RobinEpo/Star-Trekker-Microver/PCBs/for_review/StarTrekker_main_3D.png

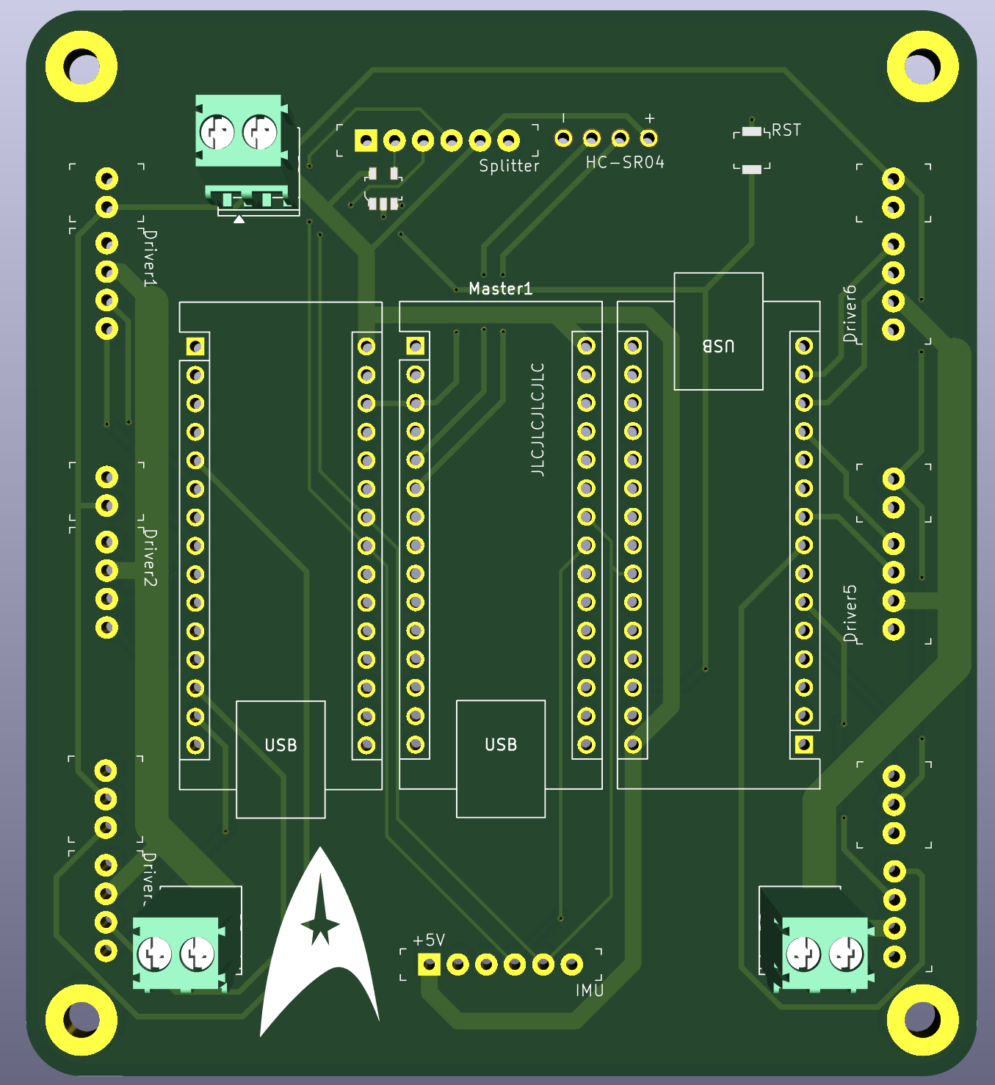
PCBs/for_review/StarTrekker_main_3D.png
