RobinEpo/Star-Trekker-Microver/PCBs/for_review/StarTrekker_main_BOTTOM_LAYER.png

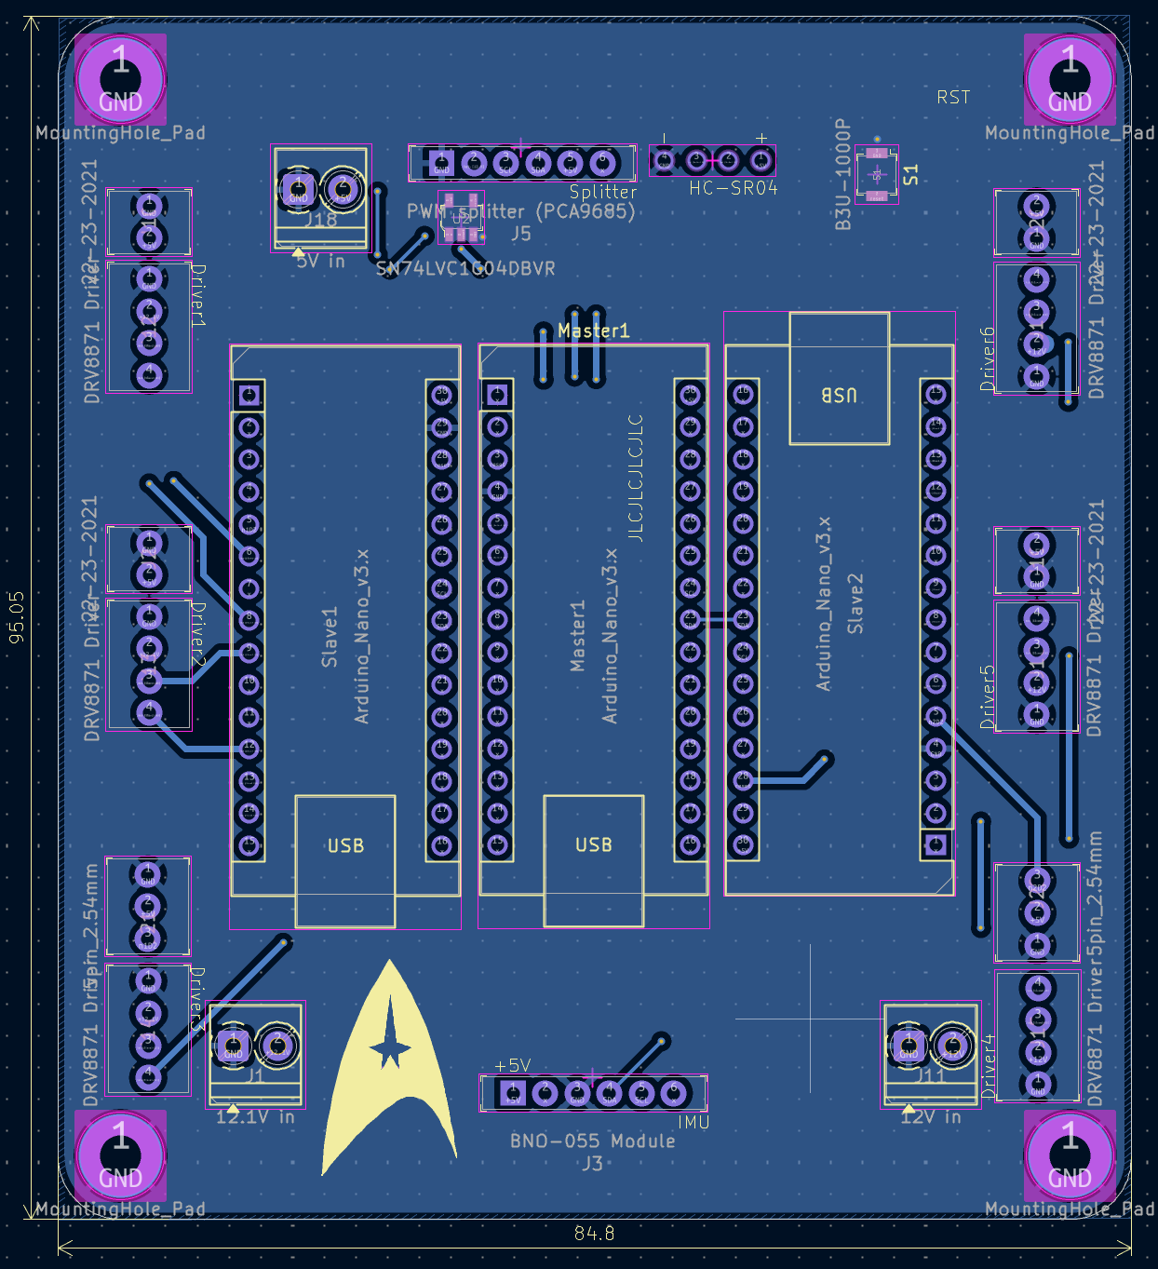
PCBs/for_review/StarTrekker_main_BOTTOM_LAYER.png
