RobinEpo/Star-Trekker-Microver/PCBs/for_review/StarTrekker_main_FULL_LAYOUT.png

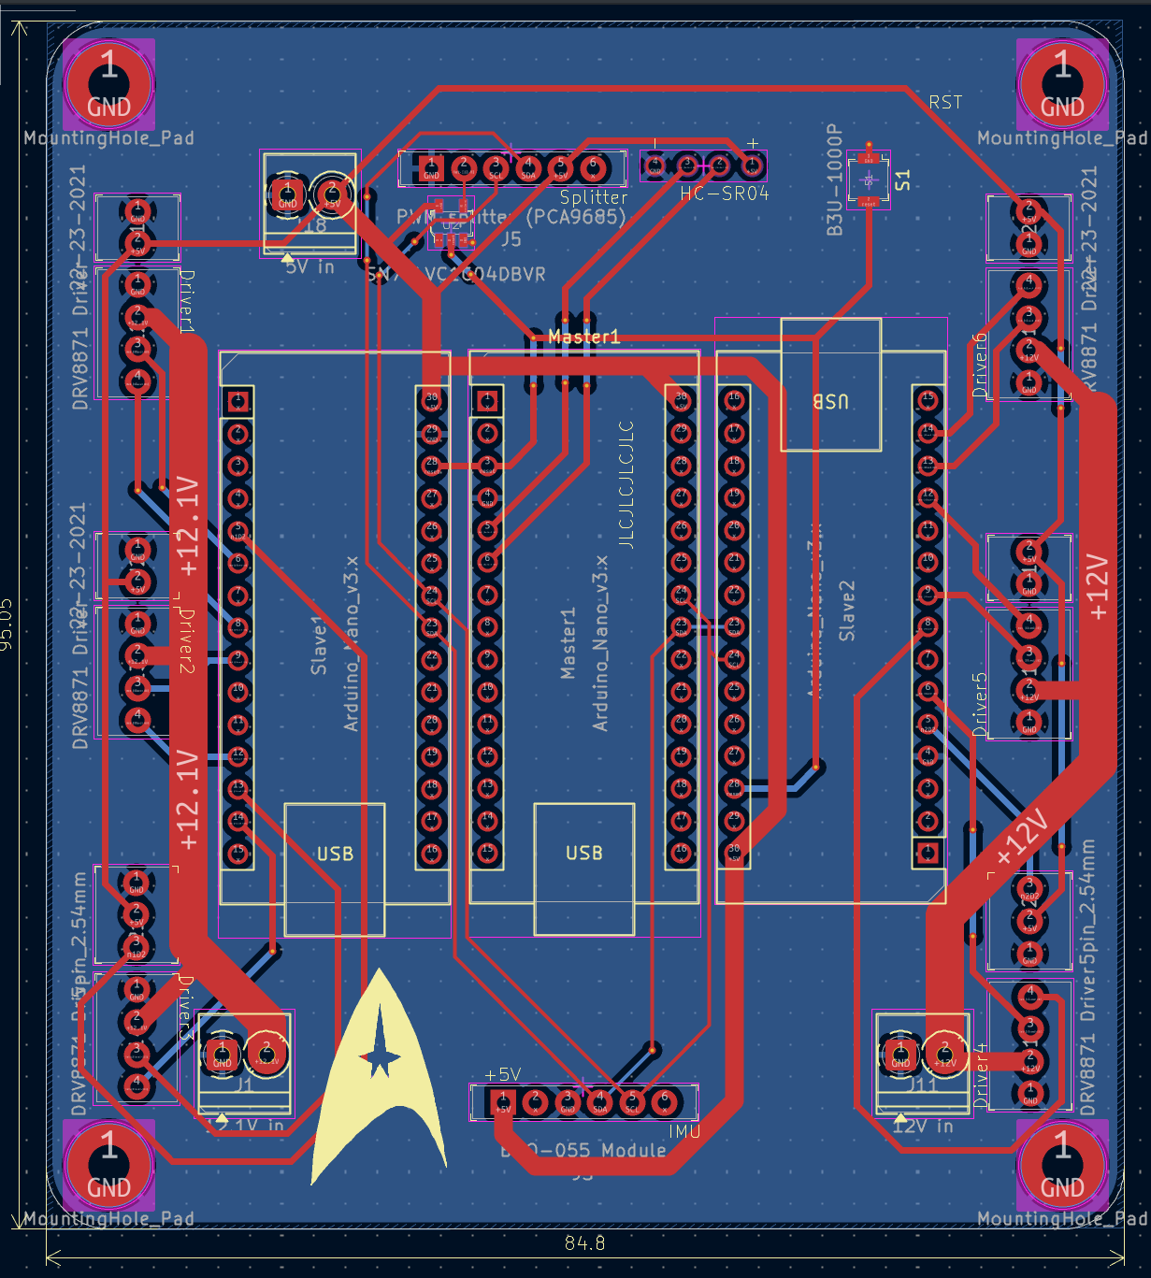
PCBs/for_review/StarTrekker_main_FULL_LAYOUT.png
