RobinEpo/Star-Trekker-Microver/PCBs/for_review/StarTrekker_main_SCHEMATIC.png

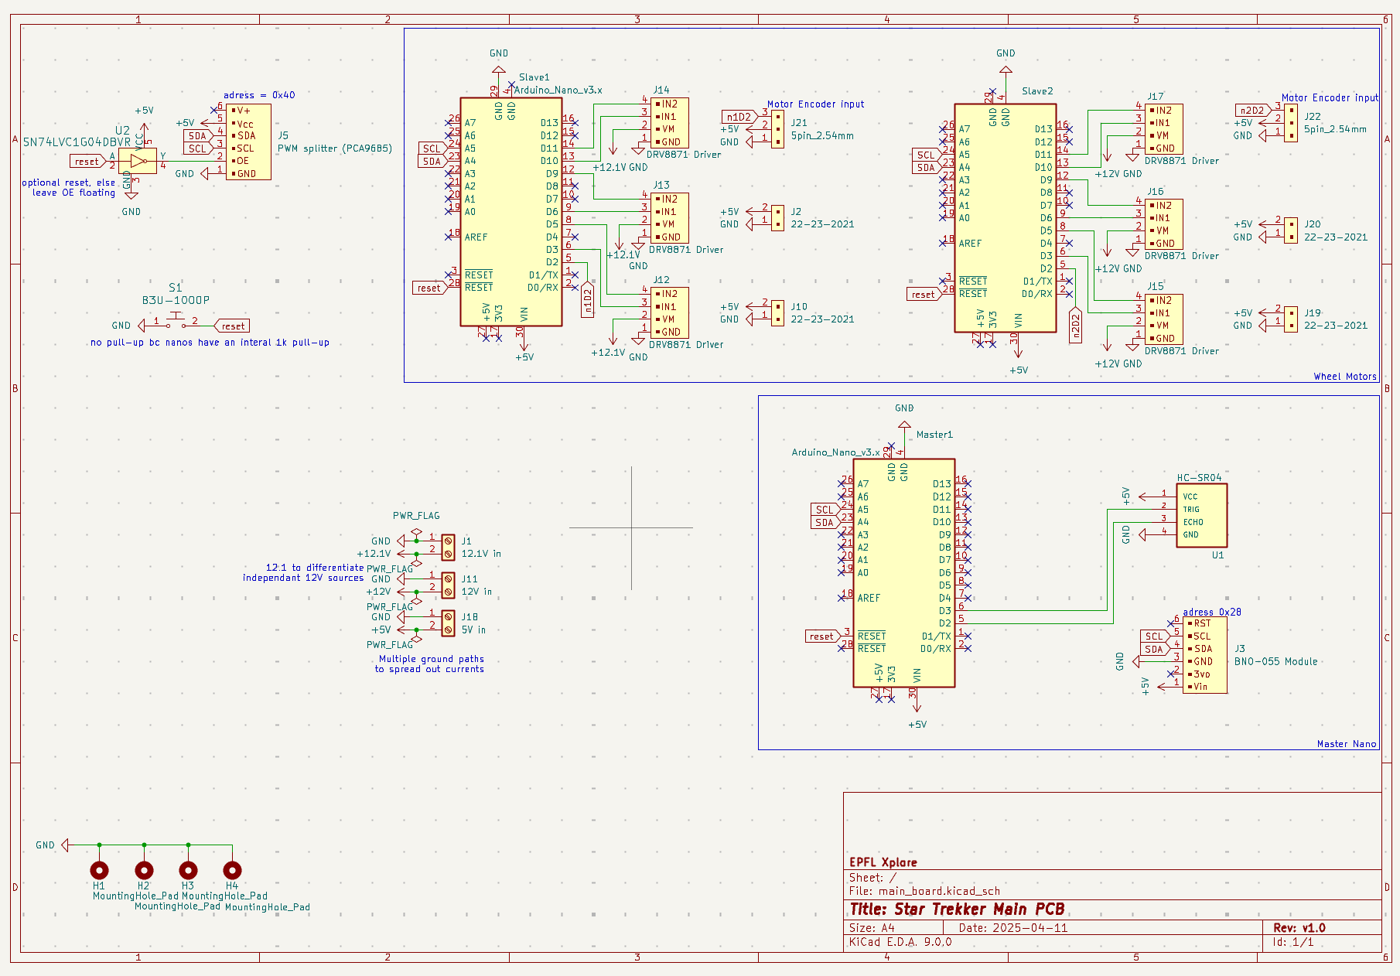
PCBs/for_review/StarTrekker_main_SCHEMATIC.png
