RobinEpo/Star-Trekker-Microver/PCBs/for_review/StarTrekker_pwrboard_3D.png

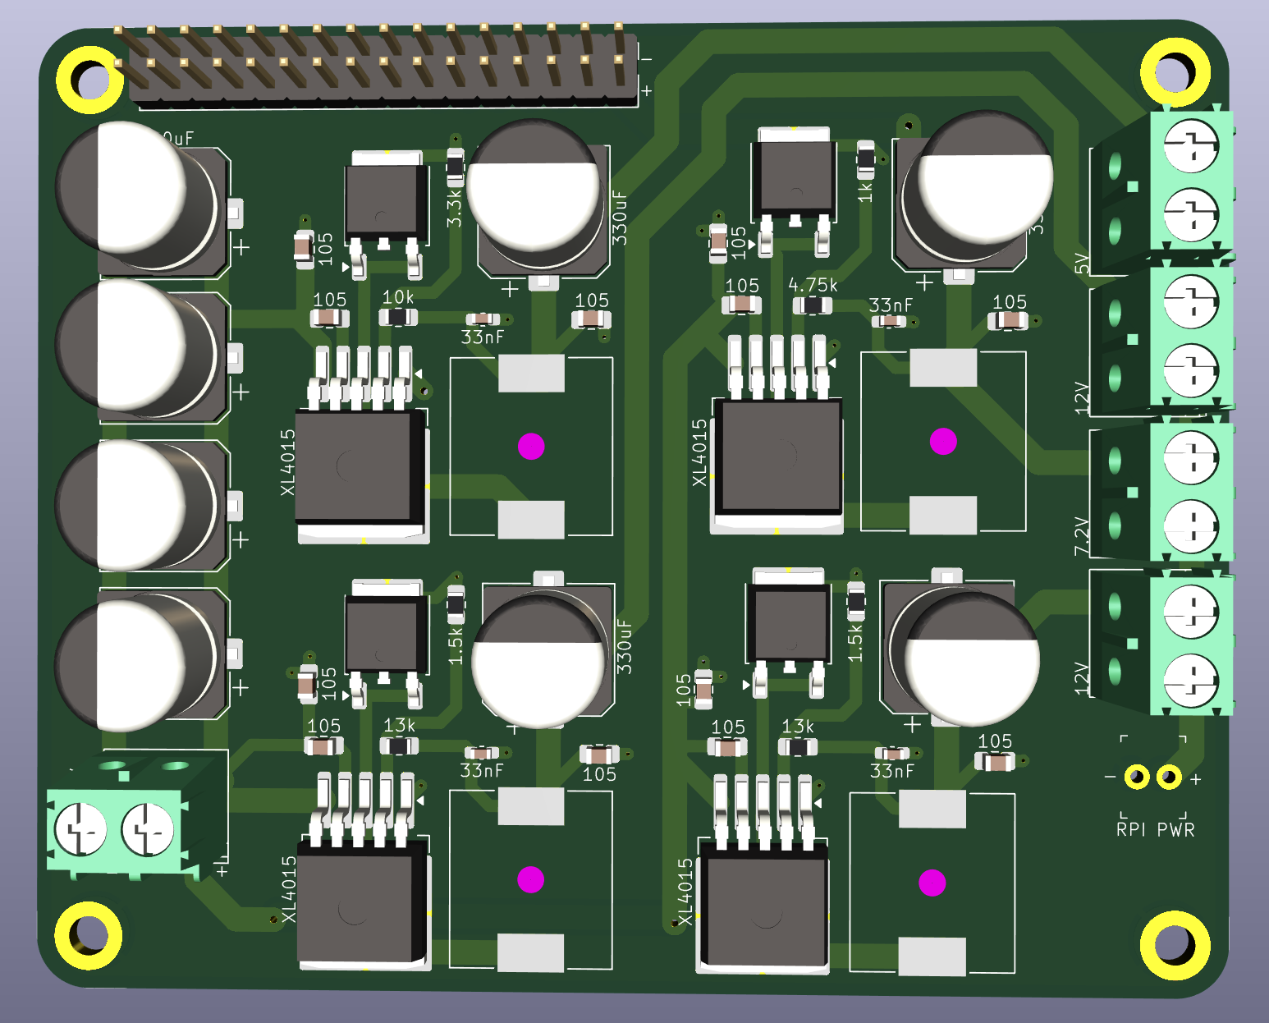
PCBs/for_review/StarTrekker_pwrboard_3D.png
