RobinEpo/Star-Trekker-Microver/PCBs/for_review/StarTrekker_pwrboard_BUTTOM_LAYER.png

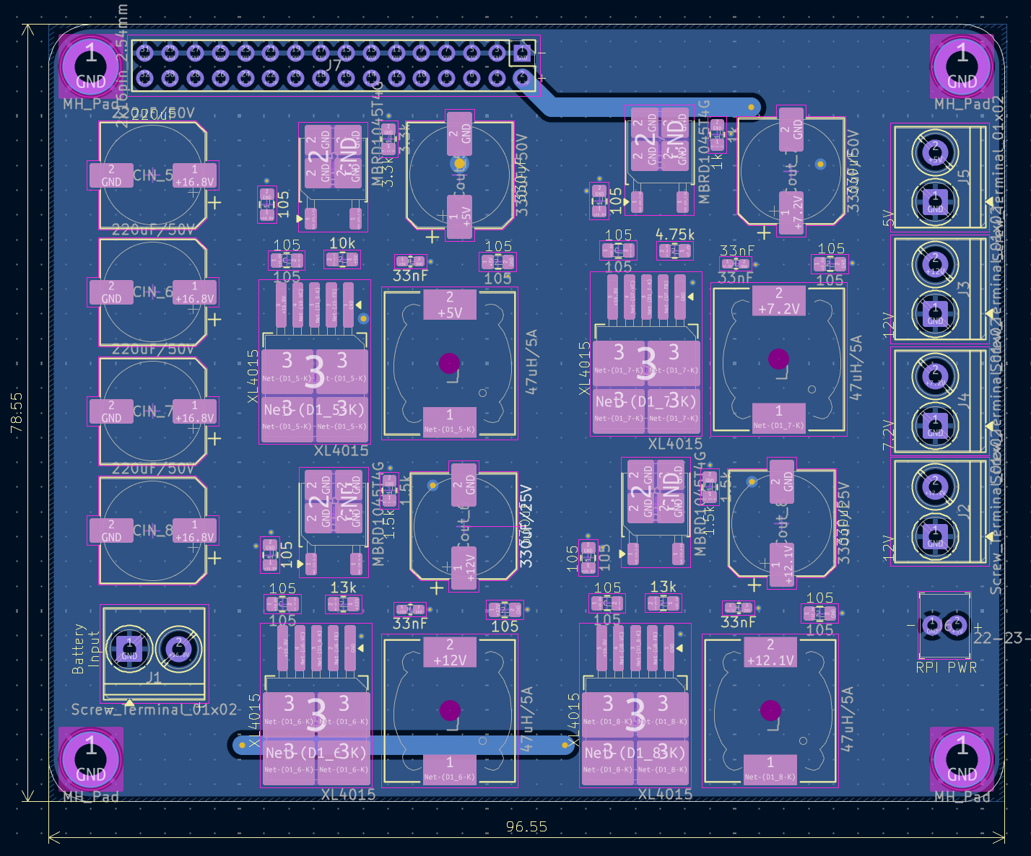
PCBs/for_review/StarTrekker_pwrboard_BUTTOM_LAYER.png
