RobinEpo/Star-Trekker-Microver/PCBs/for_review/StarTrekker_pwrboard_FULL_LAYOUT.png

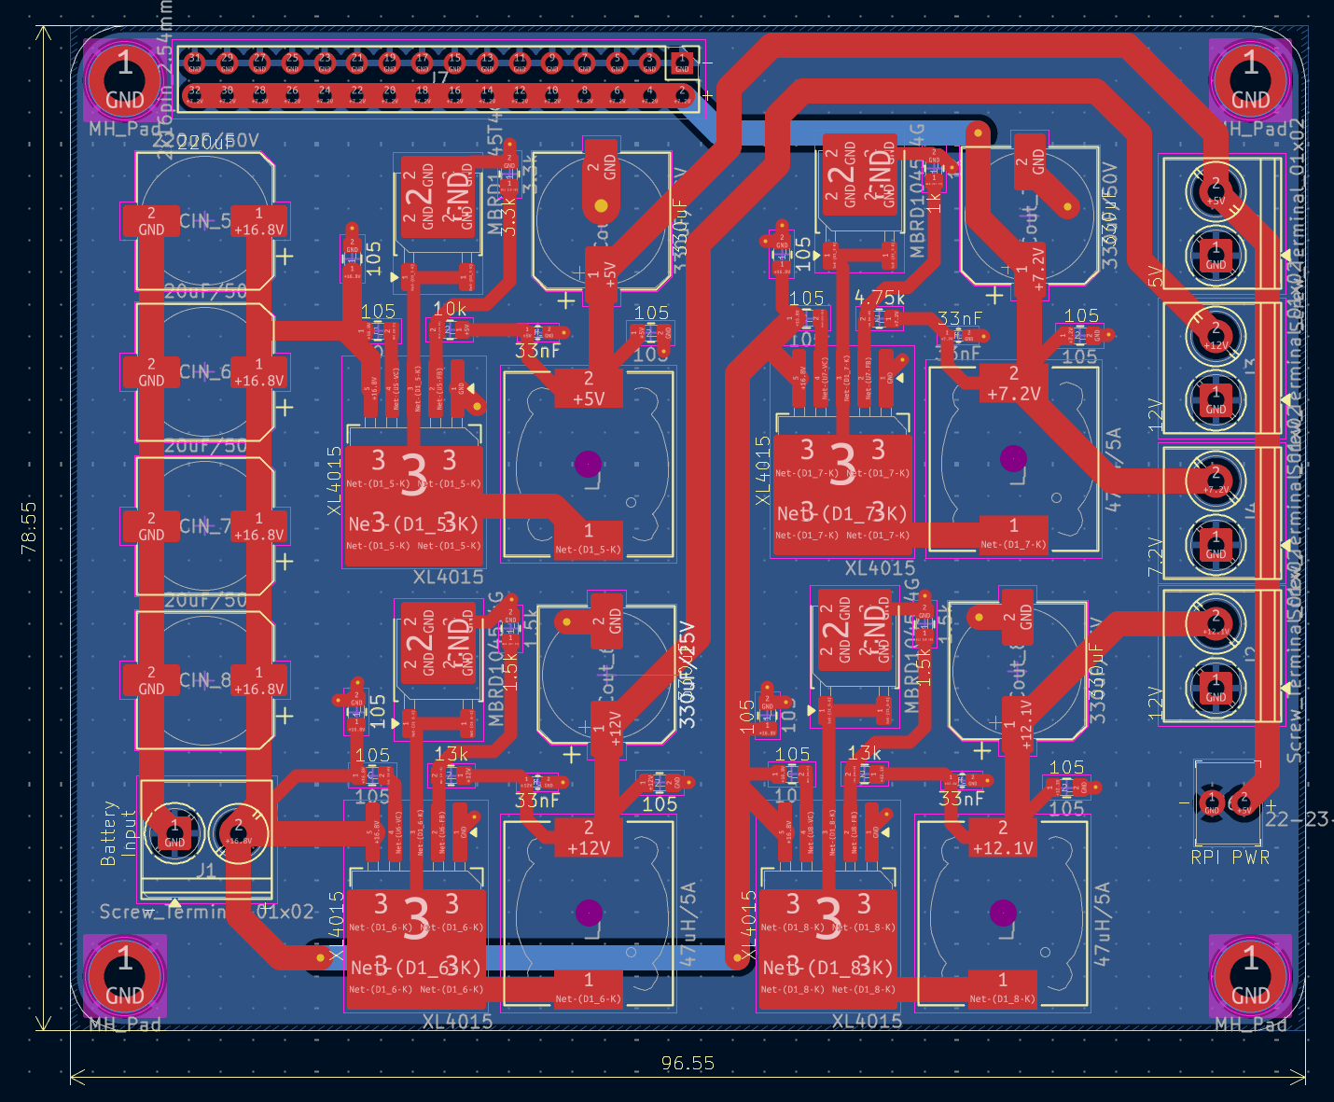
PCBs/for_review/StarTrekker_pwrboard_FULL_LAYOUT.png
