RobinEpo/Star-Trekker-Microver/PCBs/for_review/StarTrekker_pwrboard_SCHEMATIC.png

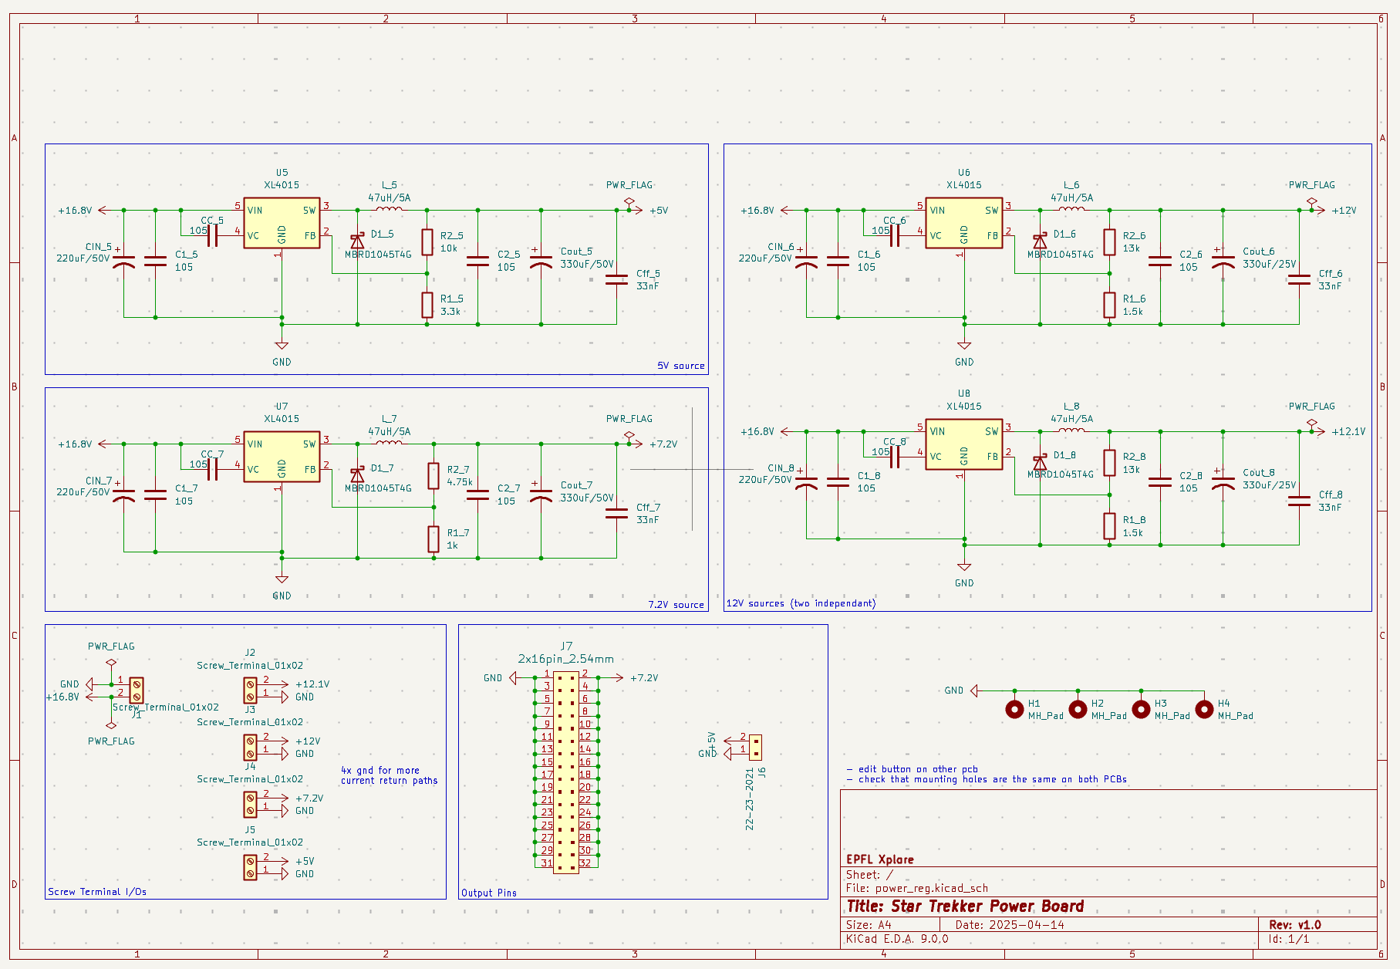
PCBs/for_review/StarTrekker_pwrboard_SCHEMATIC.png
