RobinEpo/Star-Trekker-Microver/PCBs/for_review/PwrReg_schematic.pdf

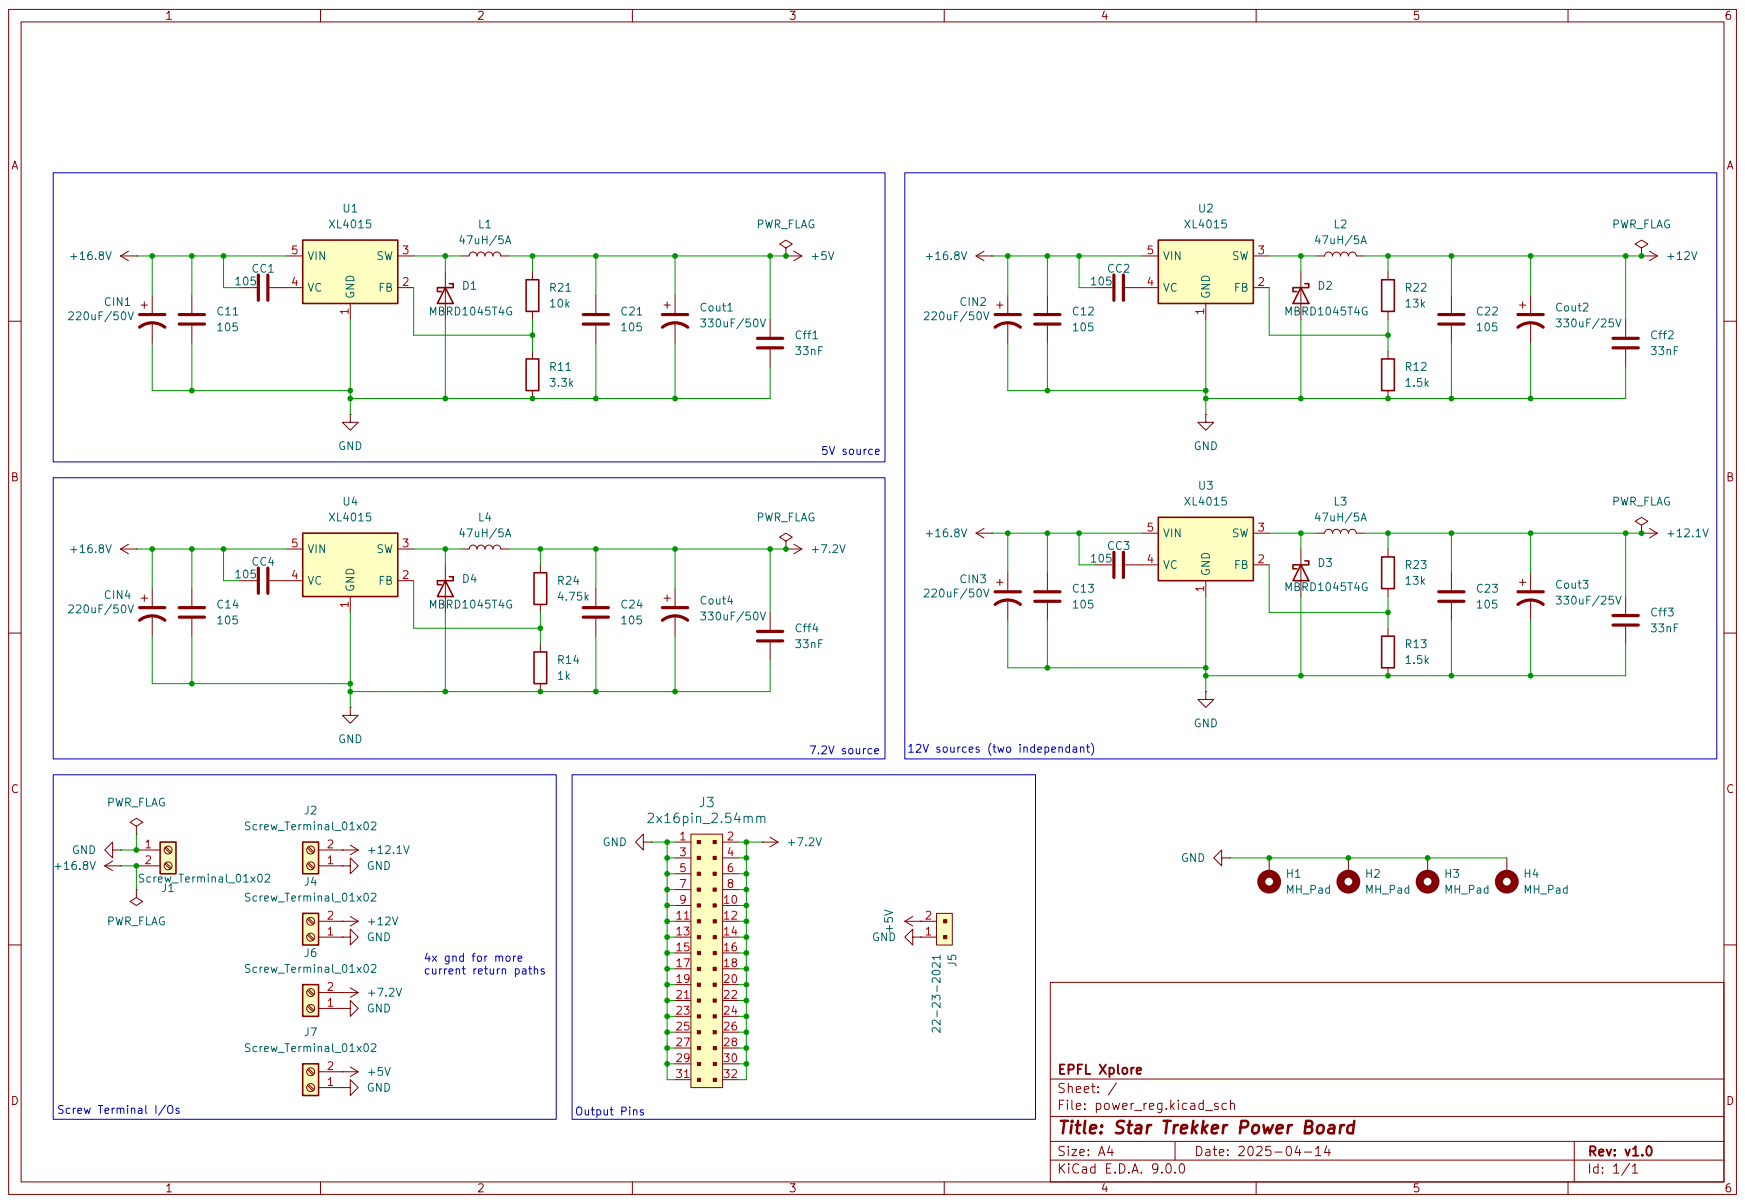
[picture p9: page 1]
