RobinEpo/Star-Trekker-Microver/PCBs/power_reg/power_reg.kicad_pcb

## KiCad design PCBs/power_reg/power_reg.kicad_pcb (2025-05-09)

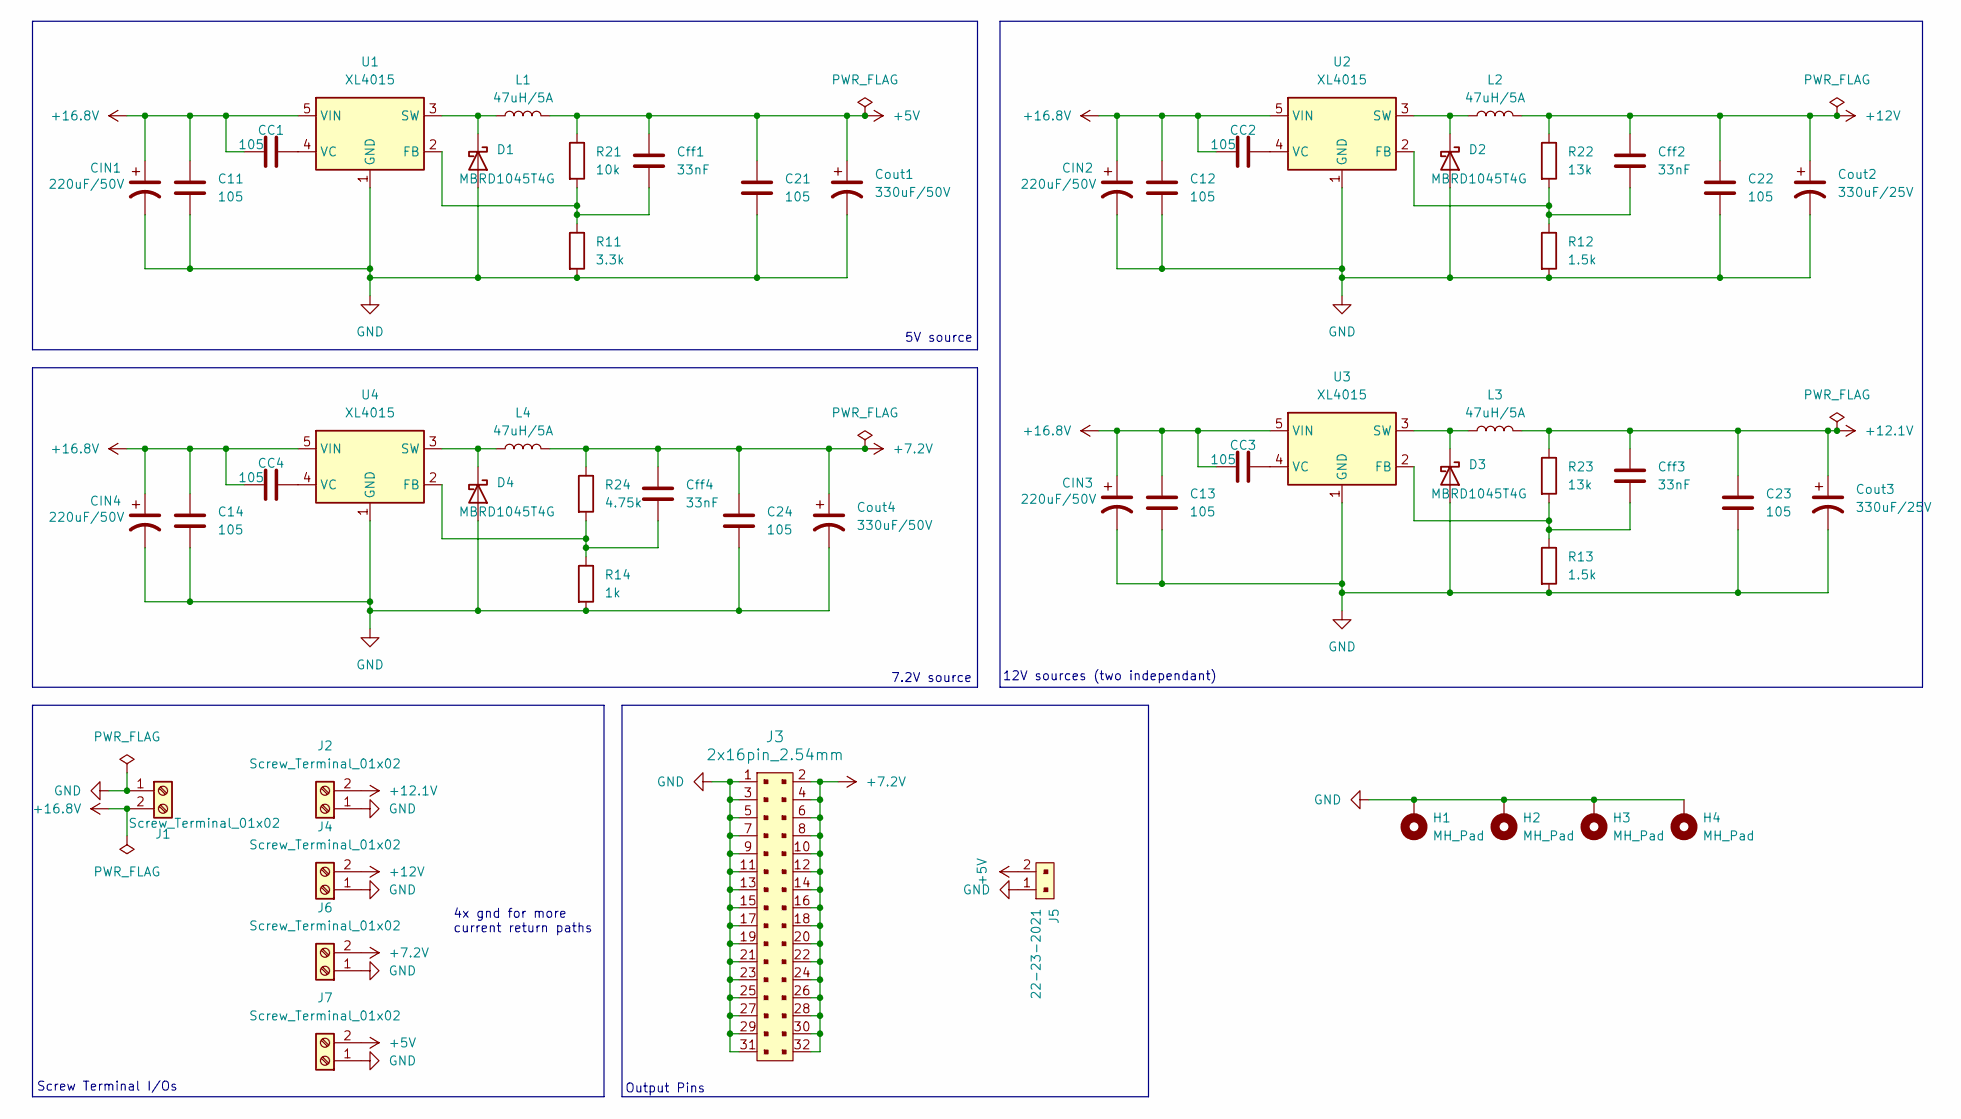
[picture p10: schematic power_reg.kicad_sch, Star Trekker Power Board]

Parts:
C11, C12, C13, C14, C21, C22, C23, C24: 105; C_0805_2012Metric_Pad1.18x1.45mm_HandSolder
CC1, CC2, CC3, CC4: 105; C_0805_2012Metric_Pad1.18x1.45mm_HandSolder
CIN1, CIN2, CIN3, CIN4: 220uF/50V; CP_Elec_10x10.5
Cff1, Cff2, Cff3, Cff4: 33nF; C_0603_1608Metric_Pad1.08x0.95mm_HandSolder
Cout1, Cout4: 330uF/50V; CP_Elec_10x10.5
Cout2, Cout3: 330uF/25V; CP_Elec_10x10.5
D1, D2, D3, D4: MBRD1045T4G; TO-252-2
H1, H2, H3, H4: MH_Pad; MountingHole_3.2mm_M3_DIN965_Pad
J1, J2, J4, J6, J7: Screw_Terminal_01x02; TerminalBlock_Phoenix_PT-1,5-2-5.0-H_1x02_P5.00mm_Horizontal
J3: 2x16pin_2.54mm; PinHeader_2x16_P2.54mm_Vertical; MPN 3220-10-0100-00; Digi-Key_PN 1175-1627-ND
J5: 22-23-2021; PinHeader_1x2_P2.54mm_Drill1.02mm; MPN 22-23-2021; Digi-Key_PN WM4200-ND
L1, L2, L3, L4: 47uH/5A; L_13.8x12.6mm_H6.5mm
R11: 3.3k; R_0805_2012Metric_Pad1.20x1.40mm_HandSolder
R12, R13: 1.5k; R_0805_2012Metric_Pad1.20x1.40mm_HandSolder
R14: 1k; R_0805_2012Metric_Pad1.20x1.40mm_HandSolder
R21: 10k; R_0805_2012Metric_Pad1.20x1.40mm_HandSolder
R22, R23: 13k; R_0805_2012Metric_Pad1.20x1.40mm_HandSolder
R24: 4.75k; R_0805_2012Metric_Pad1.20x1.40mm_HandSolder
U1, U2, U3, U4: XL4015; TO-263-5_TabPin3

Connections:
+5V: C21.1, Cff1.1, Cout1.1, J5.2, J7.2, L1.2, R21.1
+7.2V: C24.1, Cff4.1, Cout4.1, J3.2, J3.4, J3.6, J3.8, J3.10, J3.12, J3.14, J3.16, J3.18, J3.20, J3.22, J3.24, J3.26, J3.28, J3.30, J3.32, J6.2, L4.2, R24.1
+12.1V: C23.1, Cff3.1, Cout3.1, J2.2, L3.2, R23.1
+12V: C22.1, Cff2.1, Cout2.1, J4.2, L2.2, R22.1
+16.8V: C11.1, C12.1, C13.1, C14.1, CC1.1, CC2.1, CC3.1, CC4.1, CIN1.1, CIN2.1, CIN3.1, CIN4.1, J1.2, U1.5 (VIN), U2.5 (VIN), U3.5 (VIN), U4.5 (VIN)
GND: C11.2, C12.2, C13.2, C14.2, C21.2, C22.2, C23.2, C24.2, CIN1.2, CIN2.2, CIN3.2, CIN4.2, Cout1.2, Cout2.2, Cout3.2, Cout4.2, D1.1 (A), D2.1 (A), D3.1 (A), D4.1 (A), H1.1, H2.1, H3.1, H4.1, J1.1, J2.1, J3.1, J3.3, J3.5, J3.7, J3.9, J3.11, J3.13, J3.15, J3.17, J3.19, J3.21, J3.23, J3.25, J3.27, J3.29, J3.31, J4.1, J5.1, J6.1, J7.1, R11.2, R12.2, R13.2, R14.2, U1.1 (GND), U2.1 (GND), U3.1 (GND), U4.1 (GND)
unnamed: D1.2 (K), L1.1, U1.3 (SW)
unnamed: D2.2 (K), L2.1, U2.3 (SW)
unnamed: D3.2 (K), L3.1, U3.3 (SW)
unnamed: D4.2 (K), L4.1, U4.3 (SW)
unnamed: Cff1.2, R11.1, R21.2, U1.2 (FB)
unnamed: CC1.2, U1.4 (VC)
unnamed: Cff2.2, R12.1, R22.2, U2.2 (FB)
unnamed: CC2.2, U2.4 (VC)
unnamed: Cff3.2, R13.1, R23.2, U3.2 (FB)
unnamed: CC3.2, U3.4 (VC)
unnamed: Cff4.2, R14.1, R24.2, U4.2 (FB)
unnamed: CC4.2, U4.4 (VC)

Notes on the sheet:
Output Pins
5V source
Screw Terminal I/Os
7.2V source
12V sources (two independant)
4x gnd for more current return paths

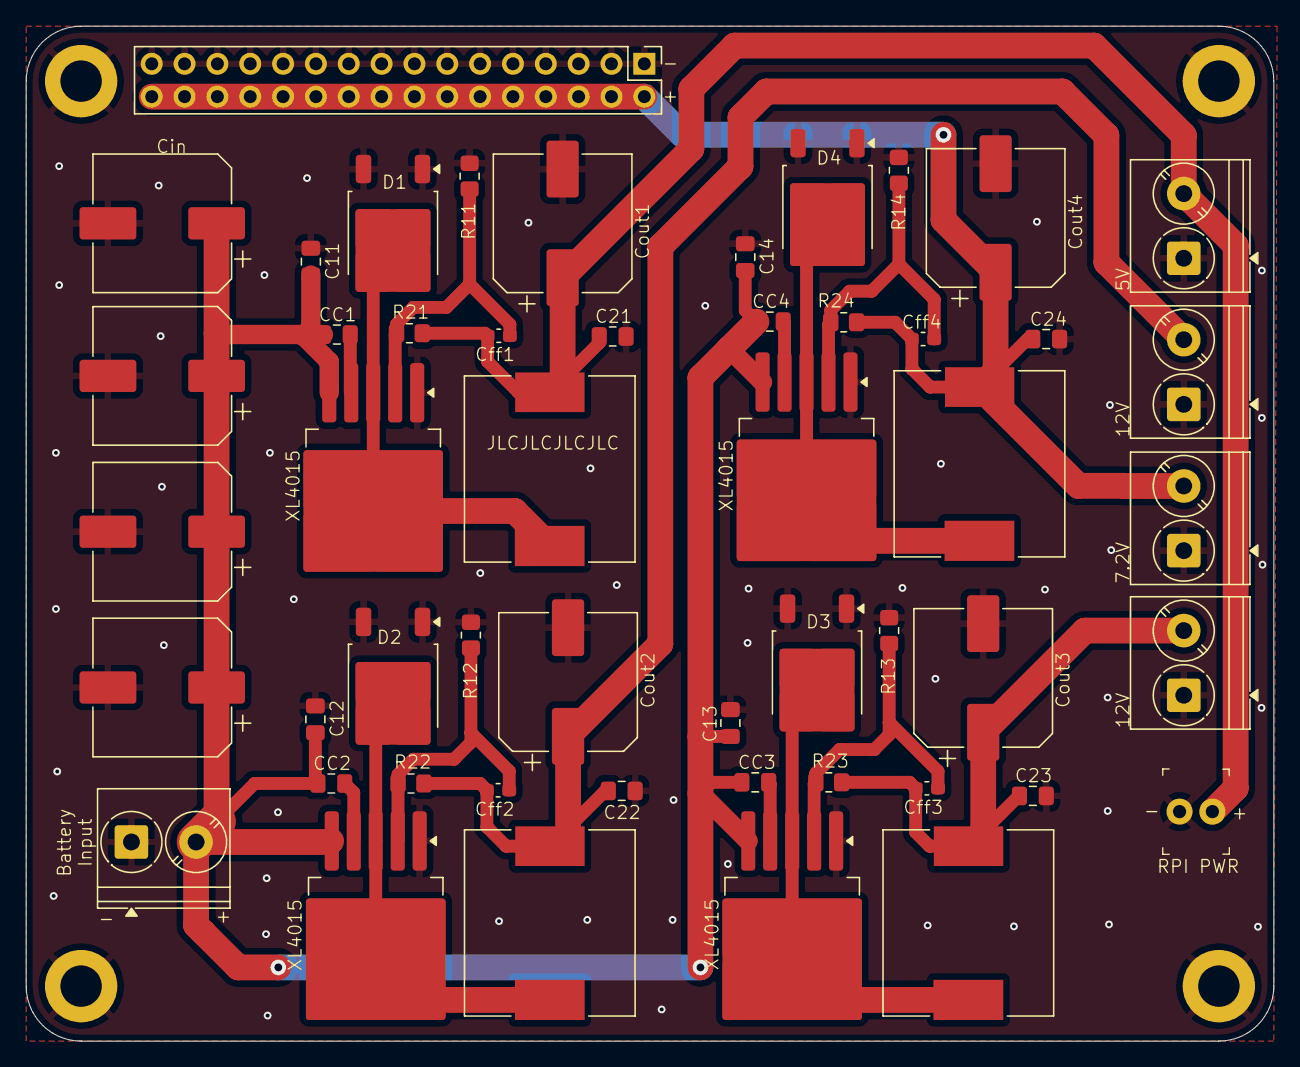
[picture p11: board power_reg.kicad_pcb from above]

Board: 2 copper layers, 96.5 x 78.5 mm, 55 parts (0 on the bottom side), 18 nets.
