RobinEpo/Star-Trekker-Microver/PCBs/main_board/main_board.kicad_pcb

## KiCad design PCBs/main_board/main_board.kicad_pcb (2025-05-09)

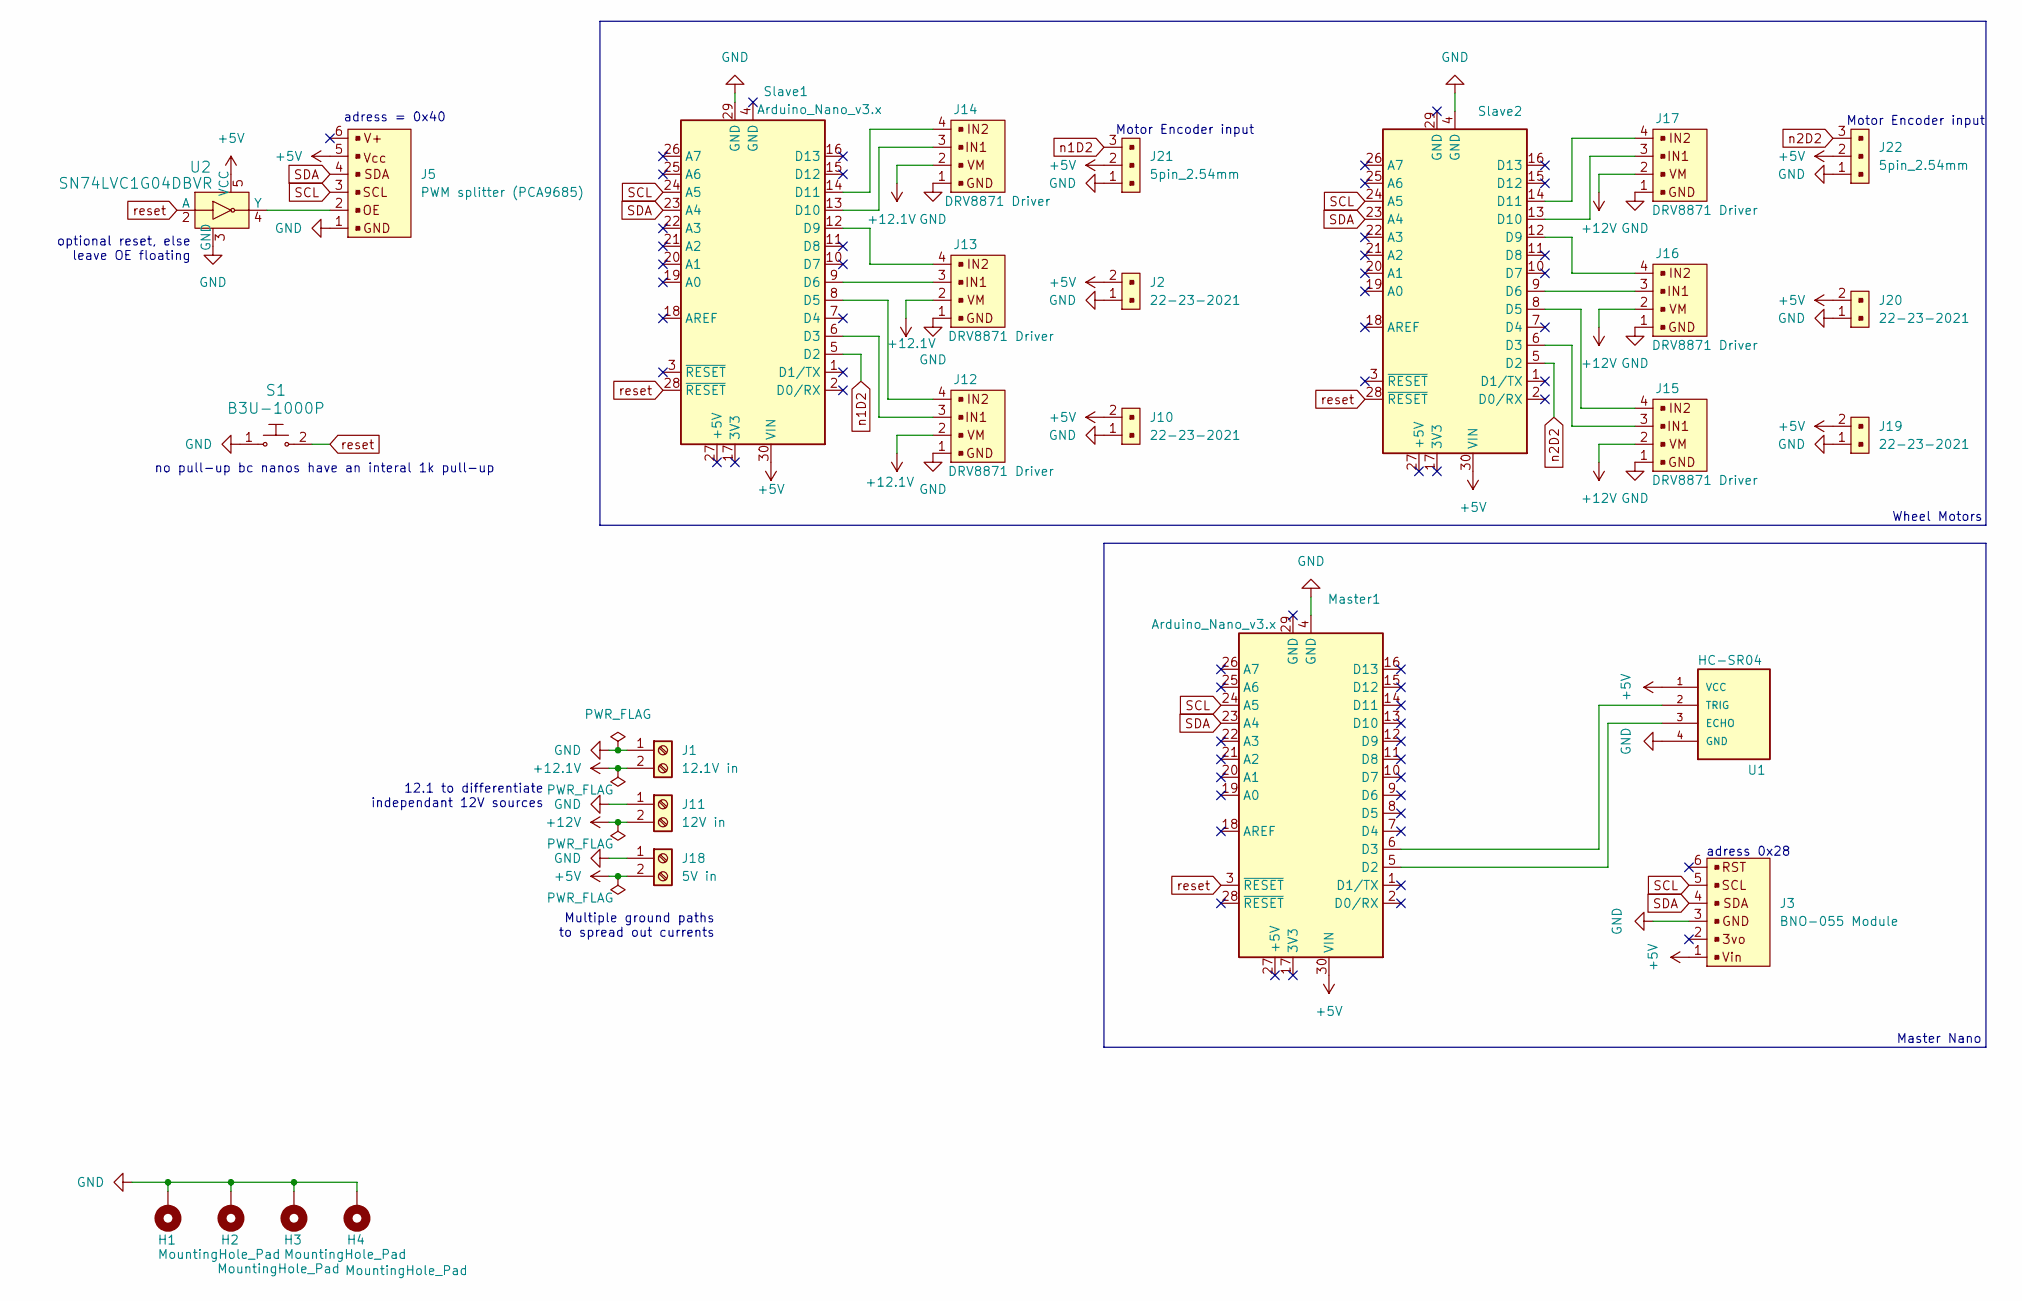
[picture p12: schematic main_board.kicad_sch, Star Trekker Main PCB]

Parts:
H1, H2, H3, H4: MountingHole_Pad; MountingHole_3.2mm_M3_Pad
J1: 12.1V in; TerminalBlock_Phoenix_PT-1,5-2-3.5-H_1x02_P3.50mm_Horizontal
J2, J10, J19, J20: 22-23-2021; PinHeader_1x2_P2.54mm_Drill1.02mm; MPN 22-23-2021; Digi-Key_PN WM4200-ND
J3: BNO-055 Module; my_6pin_2_frown; MPN B4B-XH-A(LF)(SN); Digi-Key_PN 455-2249-ND
J5: PWM splitter (PCA9685); my_6pin_2_frown; MPN B4B-XH-A(LF)(SN); Digi-Key_PN 455-2249-ND
J11: 12V in; TerminalBlock_Phoenix_PT-1,5-2-3.5-H_1x02_P3.50mm_Horizontal
J12, J13, J14, J15, J16, J17: DRV8871 Driver; PinHeader_1x4_P2.54mm_Drill1.02mm; MPN B4B-XH-A(LF)(SN); Digi-Key_PN 455-2249-ND
J18: 5V in; TerminalBlock_Phoenix_PT-1,5-2-3.5-H_1x02_P3.50mm_Horizontal
J21, J22: 5pin_2.54mm; PinHeader_1x3_P2.54mm_Drill1.02mm_1; MPN B5B-XH-A(LF)(SN); Digi-Key_PN 455-2270-ND
Master1: Arduino_Nano_v3.x; Arduino_Nano
S1: B3U-1000P; Switch_Tactile_SMD_B3U-1000P; MPN B3U-1000P; Digi-Key_PN SW1020CT-ND
Slave1, Slave2: Arduino_Nano_v3.x; Arduino_Nano
U1: HC-SR04; HC_SR-04_only_pins
U2: SN74LVC1G04DBVR; SOT-753; MPN SN74LVC1G04DBVR; Digi-Key_PN 296-11599-1-ND

Connections:
+5V: J2.2, J3.1, J5.5, J10.2, J18.2, J19.2, J20.2, J21.2, J22.2, Master1.30 (VIN), Slave1.30 (VIN), Slave2.30 (VIN), U1.1 (VCC), U2.5 (VCC)
+12.1V: J1.2, J12.2, J13.2, J14.2
+12V: J11.2, J15.2, J16.2, J17.2
GND: H1.1, H2.1, H3.1, H4.1, J1.1, J2.1, J3.3, J5.1, J10.1, J11.1, J12.1, J13.1, J14.1, J15.1, J16.1, J17.1, J18.1, J19.1, J20.1, J21.1, J22.1, Master1.4 (GND), S1.1, Slave1.29 (GND), Slave2.4 (GND), U1.4 (GND), U2.3 (GND)
unnamed: Master1.5 (D2), U1.3 (ECHO)
unnamed: Master1.6 (D3), U1.2 (TRIG)
unnamed: J12.3, Slave1.6 (D3)
unnamed: J12.4, Slave1.8 (D5)
unnamed: J13.3, Slave1.9 (D6)
unnamed: J13.4, Slave1.12 (D9)
unnamed: J14.3, Slave1.13 (D10)
unnamed: J14.4, Slave1.14 (D11)
unnamed: J15.3, Slave2.6 (D3)
unnamed: J15.4, Slave2.8 (D5)
unnamed: J16.3, Slave2.9 (D6)
unnamed: J16.4, Slave2.12 (D9)
unnamed: J17.3, Slave2.13 (D10)
unnamed: J17.4, Slave2.14 (D11)
unnamed: J5.2, U2.4 (Y)
SCL: J3.5, J5.3, Master1.24 (A5), Slave1.24 (A5), Slave2.24 (A5)
SDA: J3.4, J5.4, Master1.23 (A4), Slave1.23 (A4), Slave2.23 (A4)
n1D2: J21.3, Slave1.5 (D2)
n2D2: J22.3, Slave2.5 (D2)
reset: Master1.3 (~RESET), S1.2, Slave1.28 (~RESET), Slave2.28 (~RESET), U2.2 (A)

Notes on the sheet:
Motor Encoder input
adress = 0x40
no pull-up bc nanos have an interal 1k pull-up
12.1 to differentiate independant 12V sources
Wheel Motors
adress 0x28
Master Nano
Multiple ground paths to spread out currents
optional reset, else leave OE floating

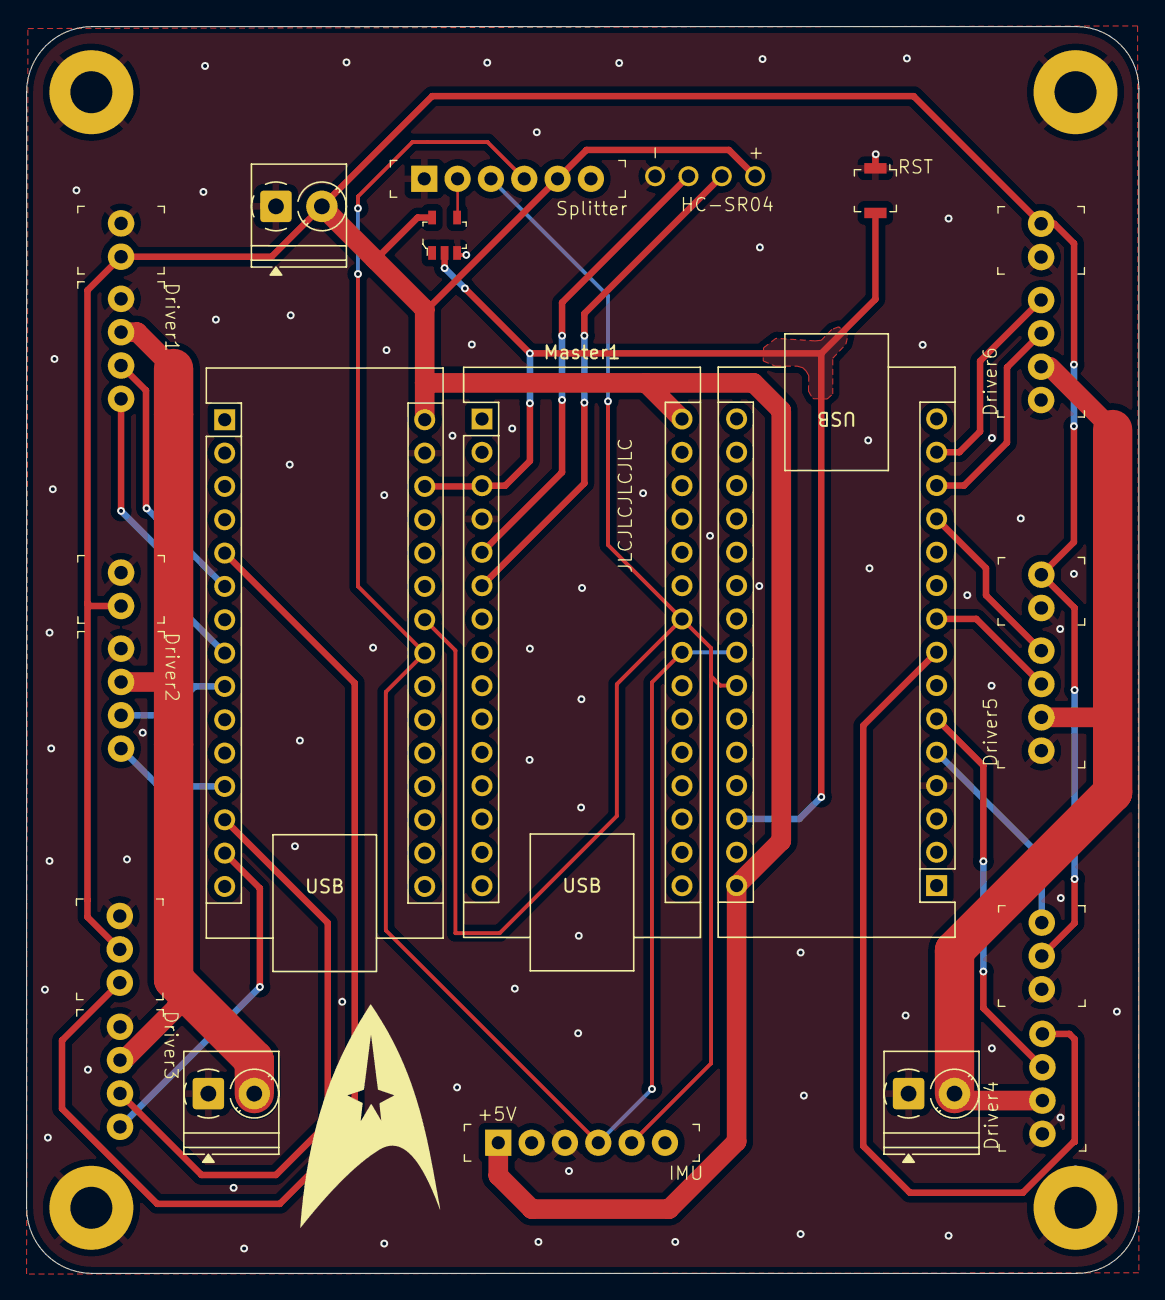
[picture p13: board main_board.kicad_pcb from above]

Board: 2 copper layers, 84.8 x 95.0 mm, 27 parts (0 on the bottom side), 24 nets.
