RobinEpo/Star-Trekker-Microver/PCBs/library downloads/Adafruit-DRV8871-Breakout-PCB-master/Adafruit DRV8871/Adafruit DRV8871.kicad_pcb

## KiCad design PCBs/library downloads/Adafruit-DRV8871-Breakout-PCB-master/Adafruit DRV8871/Adafruit DRV8871.kicad_pcb (2025-05-09)

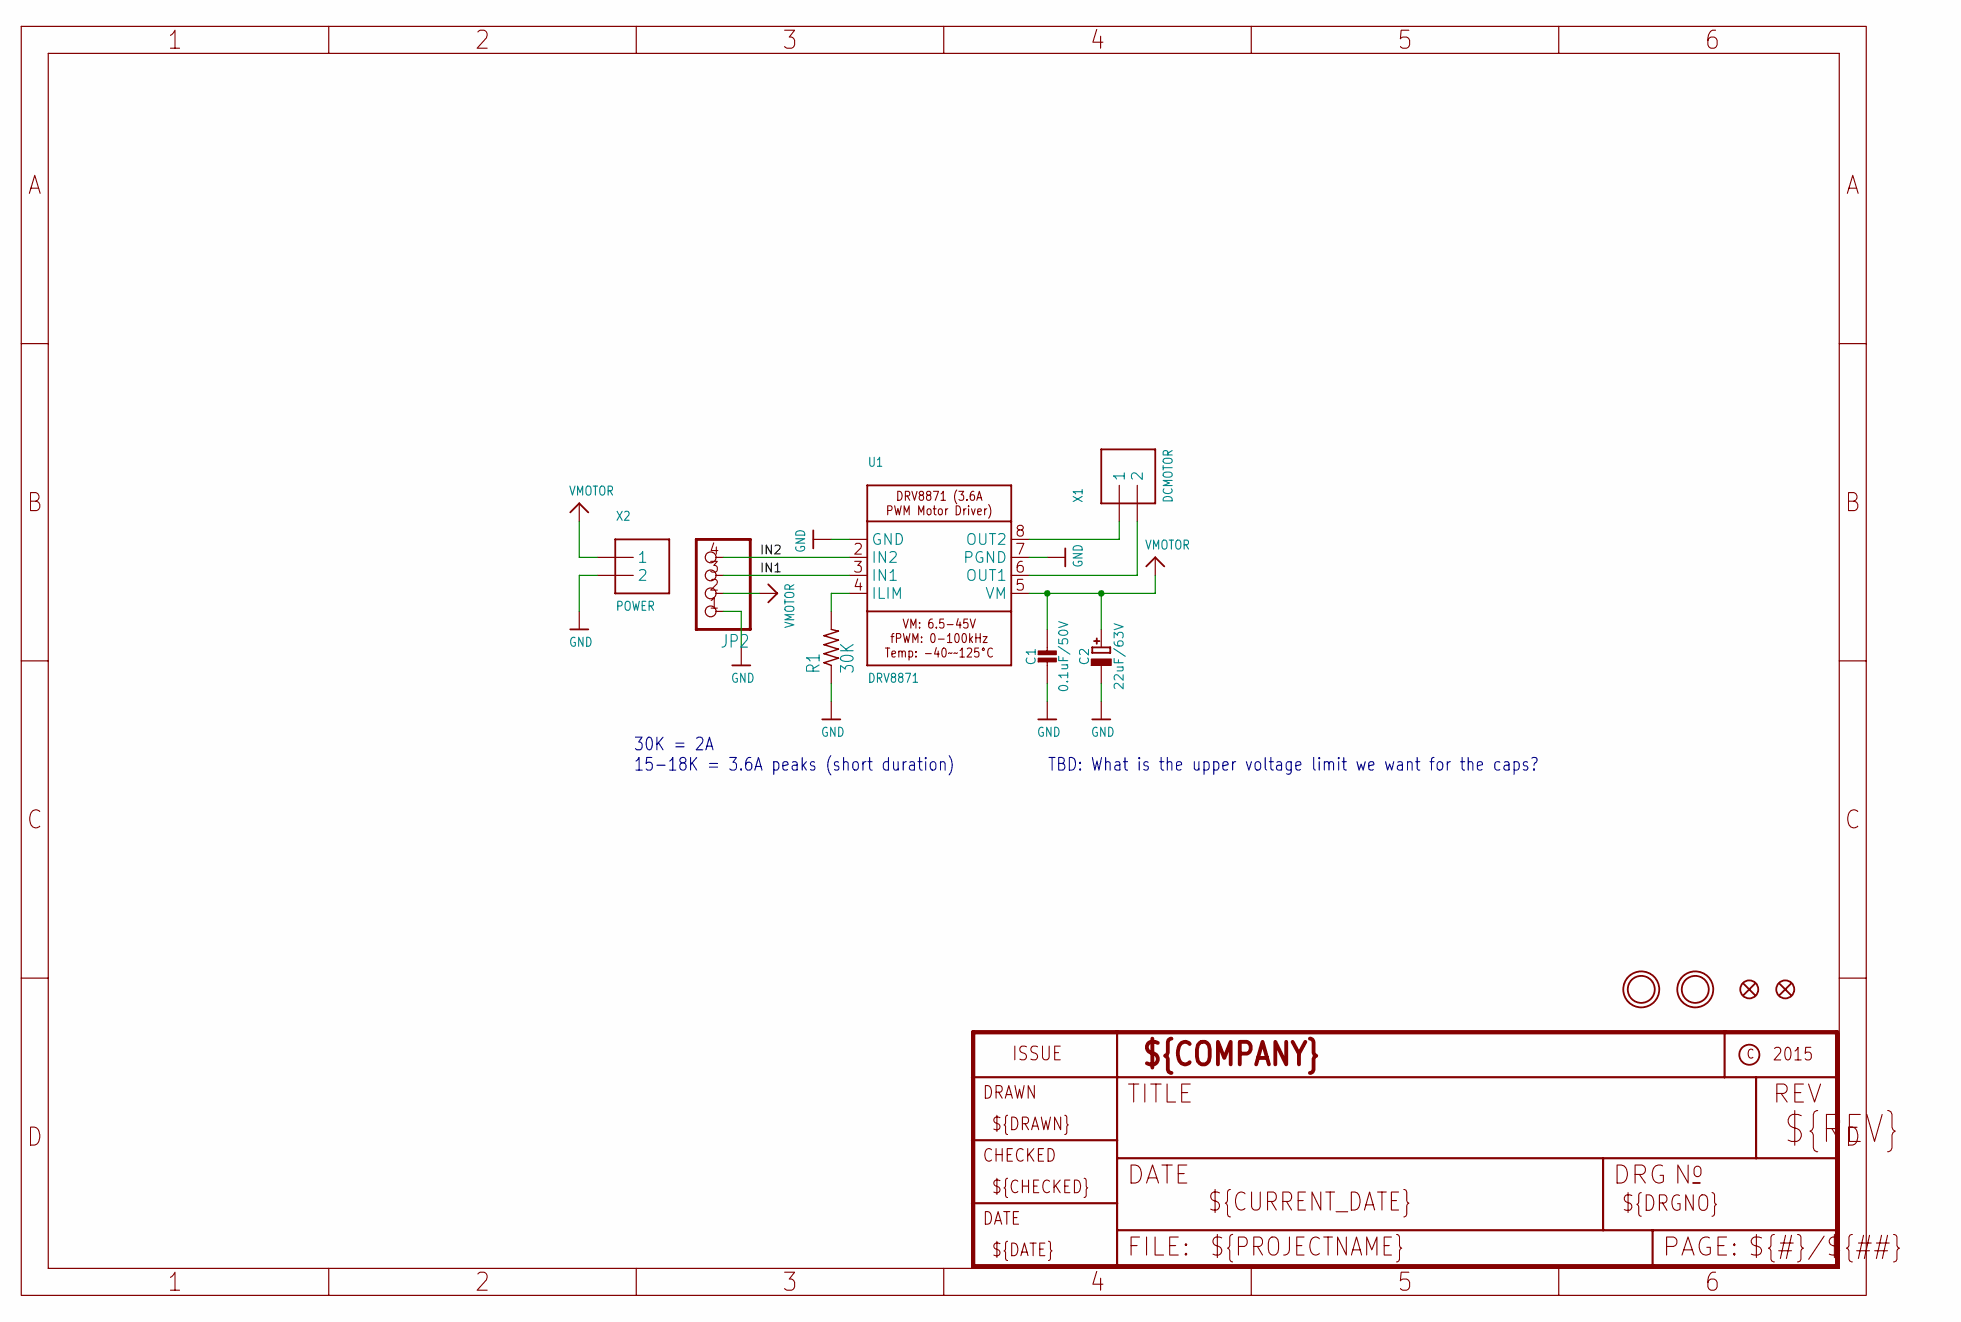
[picture p14: schematic Adafruit DRV8871.kicad_sch]

Parts:
C1: 0.1uF/50V; 0805-NO
C2: 22uF/63V; PANASONIC_D
FID1, FID2: FIDUCIAL""; FIDUCIAL_1MM
JP2: HEADER-1X476MIL; 1X04_ROUND_76
R1: 30K; 0805-THM
U1: DRV8871; HSOP8
U$9, U$10: MOUNTINGHOLE2.5; MOUNTINGHOLE_2.5_PLATED
X1: DCMOTOR; TERMBLOCK_1X2-3.5MM
X2: POWER; TERMBLOCK_1X2-3.5MM

Connections:
GND: C1.2, C2.-, JP2.1, R1.1, U1.1 (GND), U1.7 (PGND), U1.GND, U1.P$1 (GND), U1.P$2 (GND), U1.P$3 (GND), U1.P$4 (GND), X2.2
IN1: JP2.3, U1.3 (IN1)
IN2: JP2.4, U1.2 (IN2)
unnamed: R1.2, U1.4 (ILIM)
OUT1: U1.6 (OUT1), X1.2
OUT2: U1.8 (OUT2), X1.1
VMOTOR: C1.1, C2.+, JP2.2, U1.5 (VM), X2.1

Notes on the sheet:
TBD: What is the upper voltage limit we want for the caps?
30K = 2A 15-18K = 3.6A peaks (short duration~{})

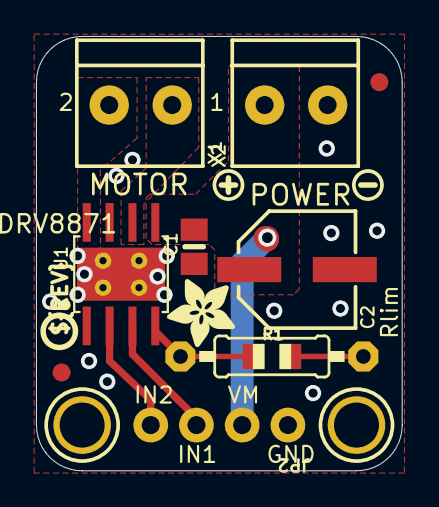
[picture p15: board Adafruit DRV8871.kicad_pcb from above]

Board: 2 copper layers, 20.3 x 24.1 mm, 15 parts (0 on the bottom side), 7 nets.

Other parts of the board:
U$11: SYMBOL_PLUS
U$12: SYMBOL_MINUS
U$14: ADAFRUIT_3.5MM
U$15: PCBFEAT-REV-040
