RobinEpo/Star-Trekker-Microver/PCBs/relay_switch/relay_board/relay_board.kicad_pcb

## KiCad design PCBs/relay_switch/relay_board/relay_board.kicad_pcb (2025-05-09)

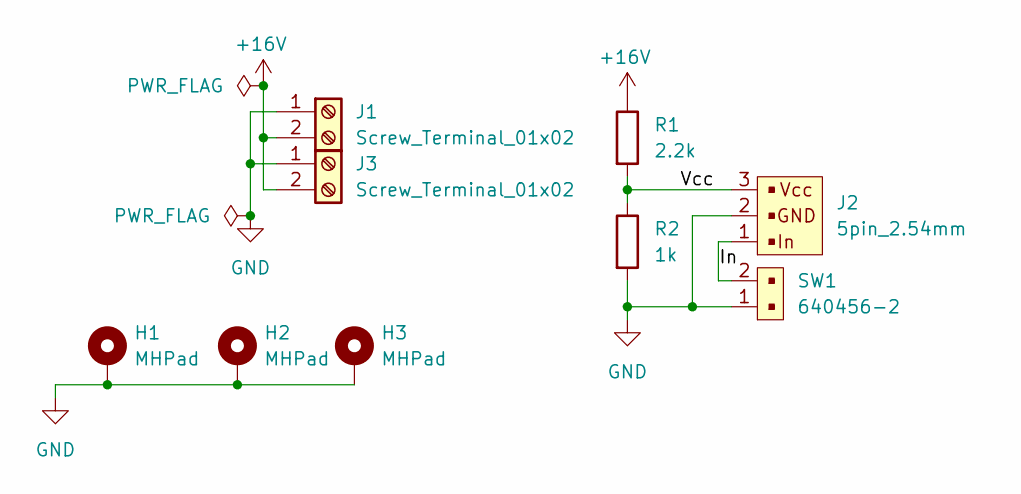
[picture p16: schematic relay_board.kicad_sch, Star Trekker Relay Board]

Parts:
H1, H2, H3: MHPad; MountingHole_3.2mm_M3_DIN965_Pad
J1, J3: Screw_Terminal_01x02; TerminalBlock_Phoenix_PT-1,5-2-5.0-H_1x02_P5.00mm_Horizontal
J2: 5pin_2.54mm; PinHeader_1x3_P2.54mm_Drill1.02mm_1; MPN B5B-XH-A(LF)(SN); Digi-Key_PN 455-2270-ND
R1: 2.2k; R_0603_1608Metric_Pad0.98x0.95mm_HandSolder
R2: 1k; R_0603_1608Metric_Pad0.98x0.95mm_HandSolder
SW1: 640456-2; PinHeader_1x2_P2.54mm_Drill1.02mm; MPN 640456-2; Digi-Key_PN A1921-ND

Connections:
+16V: J1.2, J3.2, R1.1
/In: J2.1, SW1.2
/Vcc: J2.3, R1.2, R2.1
GND: H1.1, H2.1, H3.1, J1.1, J2.2, J3.1, R2.2, SW1.1

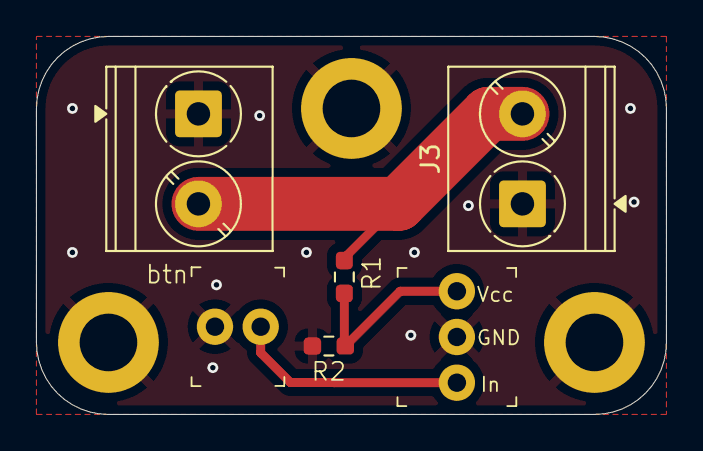
[picture p17: board relay_board.kicad_pcb from above]

Board: 2 copper layers, 35.0 x 21.0 mm, 9 parts (0 on the bottom side), 4 nets.
