RobinEpo/Star-Trekker-Microver/(commit log)

2025-04-08 first camera test with godot
2025-05-09 Create PCBs folder
2025-05-09 Added the PCBs folders, including the v2.0 of the power_reg but otherwise is just the v1.0s
    [Adafruit DRV8871.brd, Adafruit DRV8871.kicad_pcb, Adafruit DRV8871.kicad_sch, Adafruit DRV8871.sch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]
2025-05-11 Added v1.1 of arduinos codes
2025-05-11 Mati night edits - Big simplifcations in arduino codes and verified rpi to master comms
2025-05-12 Correction 2/3 bugs + debuggage léger
    Il faudra juste ne pas oublier de supprimer les lignes inutiles de print. Elles peuvent tjrs servir entre temps.
    [arm.py]
2025-05-14 Correction angles / variables globales
    [direction.py]
2025-05-15 Add values and correct transmission
    [no_laptop.py]
2025-05-15 Modified Arduino code to one that's simpler and tested works!
2025-05-17 fixed back values mistake, other mistake still pending
    [direction.py]
2025-05-21 Nouvelle version des codes (complétée avec bras)
2025-05-23 Added sensor receiver
